pacew/kaleidoscope/mirror-template.tex

% GENERATED by cad/mirror_template.py -- edit that, not this.
\documentclass[letterpaper,10pt]{article}
\usepackage[letterpaper,landscape,top=10mm,bottom=8mm,left=12mm,right=12mm]{geometry}
\usepackage{tikz}
\usepackage{xcolor}
\pagestyle{empty}
\setlength{\parindent}{0pt}
\definecolor{reg}{gray}{0.45}
\definecolor{fac}{rgb}{0.70,0.15,0.10}
\newcommand{\cmark}[2]{%
  \draw[reg,line width=0.18mm] ({#1},{#2}) circle (1.4mm);
  \draw[reg,line width=0.18mm] ({#1-2.8},{#2}) -- ({#1+2.8},{#2});
  \draw[reg,line width=0.18mm] ({#1},{#2-2.8}) -- ({#1},{#2+2.8});
}
\begin{document}
\begin{center}
  {\large\bfseries Kaleidoscope mirror cutting template}\\[0.6mm]
  {\small 255 mm scope \quad\textperiodcentered\quad one blank per sheet
   \quad\textperiodcentered\quad drawn 1:1}
\end{center}
\vspace{0.5mm}
\fbox{\parbox{\dimexpr\linewidth-2\fboxsep-2\fboxrule\relax}{\small
\textbf{Print at 100\%.} \emph{Actual size}, not \emph{Fit to page}. Check the ruler
below with a real ruler first. This sheet is nearly as wide as the paper, so also check
that the circled marks at \emph{both} ends of the blank actually printed --- if either is
missing, your printer clipped the margins and everything here is short.}}
\vspace{2.5mm}

\begin{tikzpicture}[x=1mm,y=1mm]
  \draw[line width=0.35mm] (0,0) -- (101.6,0);
  \foreach \i in {0,10,...,100} {
    \draw[line width=0.25mm] (\i,0) -- (\i,-3.0);
    \node[below,font=\scriptsize,inner sep=1pt] at (\i,-3.0) {\i};
  }
  \foreach \i in {5,15,...,95} { \draw[line width=0.18mm] (\i,0) -- (\i,-1.8); }
  \node[left,font=\scriptsize,inner sep=1pt] at (-2.2,-3.2) {mm};
  \foreach \i/\lab in {0/0, 25.4/1, 50.8/2, 76.2/3, 101.6/4} {
    \draw[line width=0.25mm] (\i,0) -- (\i,3.0);
    \node[above,font=\scriptsize,inner sep=1pt] at (\i,3.0) {\lab};
  }
  \foreach \i in {12.7,38.1,63.5,88.9} { \draw[line width=0.18mm] (\i,0) -- (\i,1.8); }
  \node[left,font=\scriptsize,inner sep=1pt] at (-2.2,3.2) {in};
  \node[right,font=\small,align=left,inner sep=3pt] at (106,0)
        {0--100 below $=$ 100.0\,mm exactly\\0--4 above $=$ 4.000\,in exactly};
\end{tikzpicture}

\vspace{4mm}
\hspace*{-4.65mm}\begin{tikzpicture}[x=1mm,y=1mm,line width=0.30mm]
  \draw (1.2868,0.0000) -- (0.0000,25.8476) -- (254.1584,51.2161) -- (256.7081,0.0000) -- cycle;
  \cmark{1.2868}{0.0000}
  \cmark{0.0000}{25.8476}
  \cmark{254.1584}{51.2161}
  \cmark{256.7081}{0.0000}
  \draw[fac,line width=0.7mm] (-4.00,0) -- (260.71,0);
  \foreach \x in {-2,2,...,260} { \draw[fac!40,line width=0.15mm] (\x,0) -- ({\x-3},-3.2); }
  \node[fac,font=\scriptsize\bfseries,below right] at (-4.00,-4.6) {FACTORY EDGE OF THE TILE — lay this line on it. Never cut or sand along it.};
  \node[reg,font=\scriptsize,below right] at (-4.00,-9.4) {Everything below the line hangs off the tile, which is how you sight the alignment.};
  \node[font=\scriptsize,reg,rotate=5.70] at (127.08,41.93) {overlap edge — cut, buried behind the next mirror};
  \node[font=\scriptsize,fac] at (129.00,3.4) {leading edge — factory, uncut, coating right to the edge};
  \node[font=\scriptsize,reg,rotate=90] at (7.29,14) {narrow end};
  \node[font=\scriptsize,reg,rotate=90] at (249.71,26) {wide end};
\end{tikzpicture}
\vspace{3mm}
\hrule
\vspace{1.5mm}
{\footnotesize
\textbf{Blank:} parallel edges \textbf{25.88} and \textbf{51.28\,mm}, both slanted edges \textbf{255.42\,mm}, height between the parallel edges \textbf{255.11\,mm}. Needs 256.7\,mm of factory edge against a 298.45\,mm tile, so one blank per edge --- three edges, or three tiles.

\smallskip

\textbf{Placing it.} Leave the protective film on. Lay the sheet so the heavy line sits on
a factory edge, with the strip below it overhanging so you can sight the alignment, and tape
it down. Prick through the centre of the four circled marks, lift the paper, join the pricks
with your straightedge, and cut only the three non-factory edges.

\smallskip

\textbf{Coated side up.} These are rear-surface mirrors. A jeweller's saw cuts on the
downstroke, so the teeth enter the top face and break out of the bottom; coated side up puts
that breakout on the clear face. Blade: a \#2, teeth pointing toward the handle.

\smallskip

\textbf{Mark the factory edge} on the coated back as soon as the blank is free. Once the
other three edges are cut it is easy to lose track of which one it was, and at assembly it
has to end up on the corner-block side of its plate.

\smallskip

\textbf{Width is forgiving, and not in the way you would guess.} Each mirror is pushed until
its leading edge stops against its neighbour, so \emph{that} edge lands on the vertex whatever
the blank measures. Width only sets how much surplus buries itself behind the next mirror.
Anything from 25.1 to 27.0\,mm across the narrow edge will seat. Too wide is the direction that fights you --- past
the limit the surplus runs out of dead space and jams against the neighbouring plate. Too narrow
only costs you: with no surplus left, the next mirror's leading edge has nothing to land on and
the seam shows as a dark line. So if you are going to miss, miss narrow.

\smallskip

\textbf{Sanding.} Only the cut edges, never the factory edge: 400-grit silicon carbide to take
the burr off, 600 to finish.
}
\end{document}
