pacew/kaleidoscope/holder/top.png

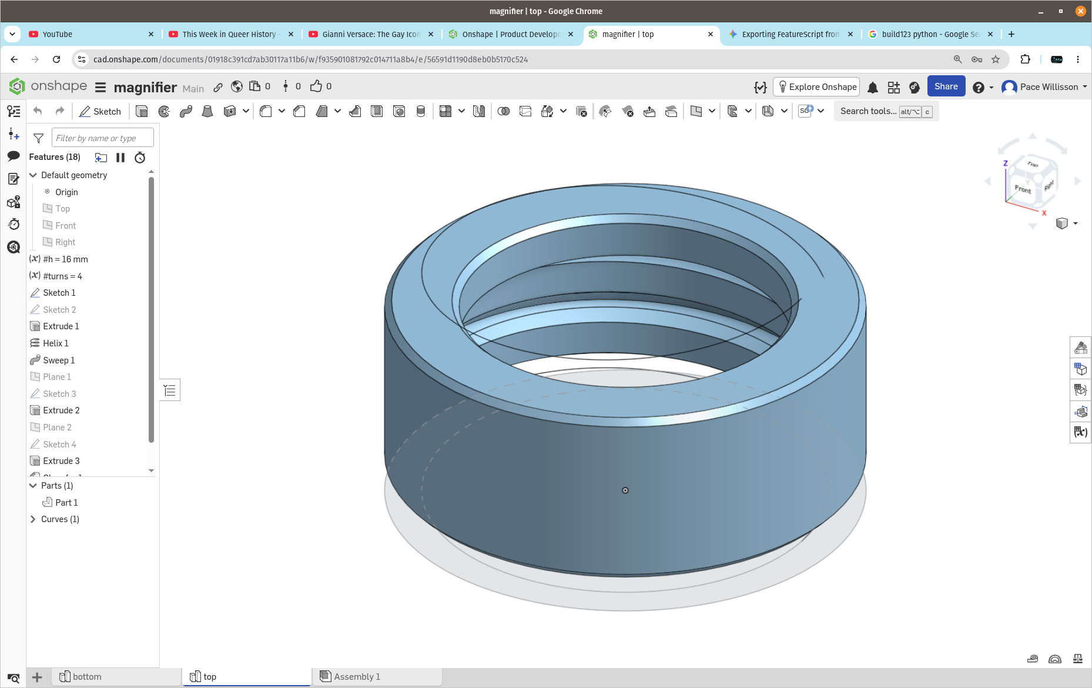
holder/top.png
