pacew/kaleidoscope/out/jewel_body.step

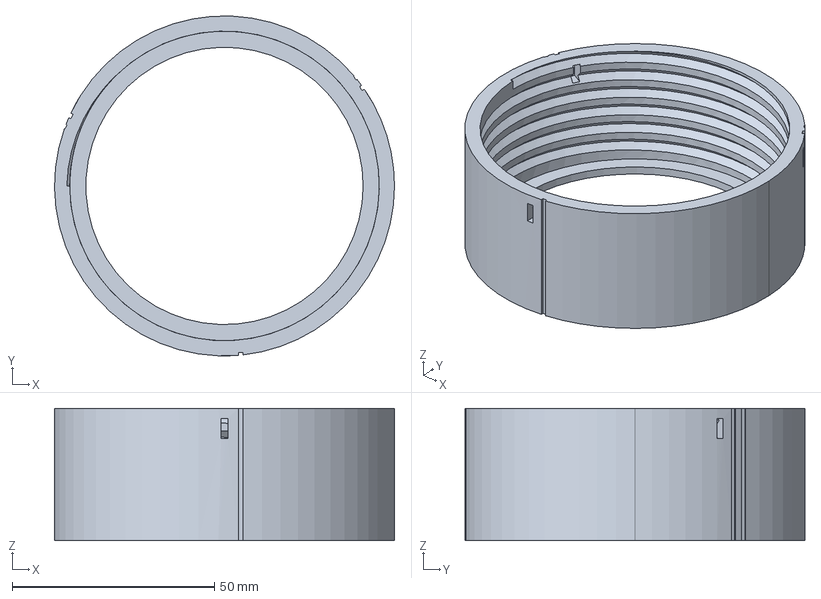
[picture p3: CAD file, 2026-09-15]
out/jewel_body.step
84.0 x 84.0 x 32.7 mm
