pacew/kaleidoscope/out/collar_225.step

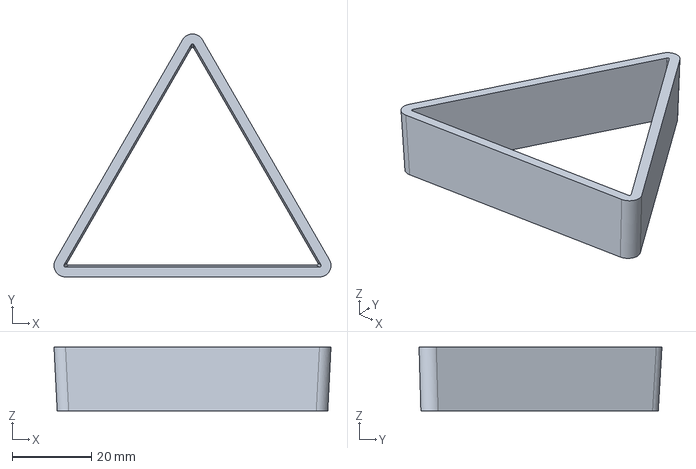
[picture p4: CAD file, 2026-09-15]
out/collar_225.step
69.7 x 61.1 x 16.0 mm
