pacew/kaleidoscope/out/jewel_test_spacer.step

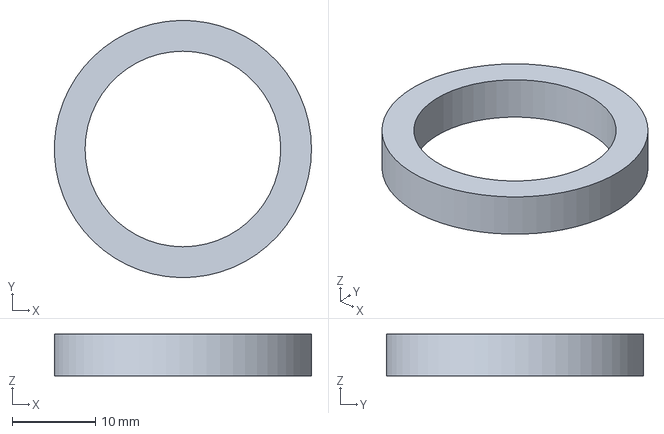
[picture p5: CAD file, 2026-09-15]
out/jewel_test_spacer.step
30.9 x 30.9 x 5.00 mm
