pacew/kaleidoscope/out/proto_side_plate.step

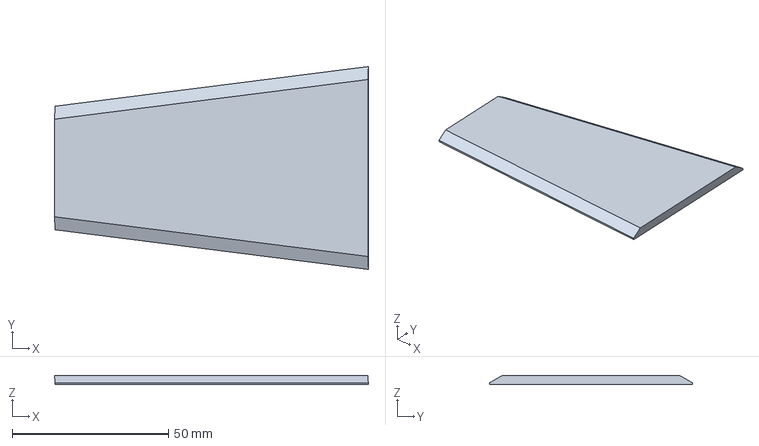
[picture p6: CAD file, 2026-09-15]
out/proto_side_plate.step
100.5 x 64.9 x 2.99 mm
