pacew/kaleidoscope/out/jewel_ring.step

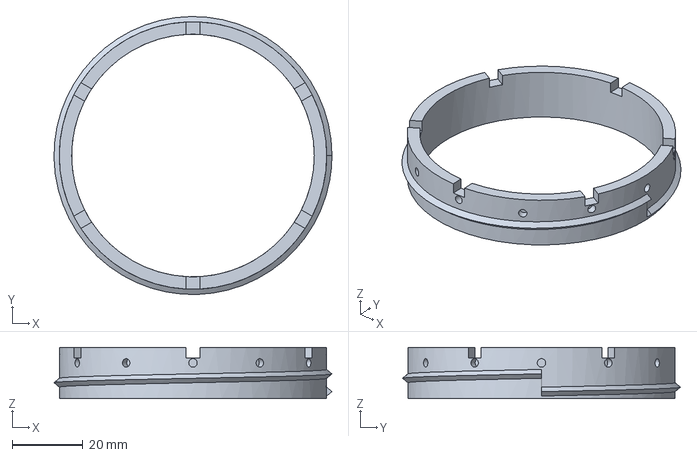
[picture p7: CAD file, 2026-09-15]
out/jewel_ring.step
78.5 x 78.5 x 14.5 mm
