pacew/kaleidoscope/out/collar_112.step

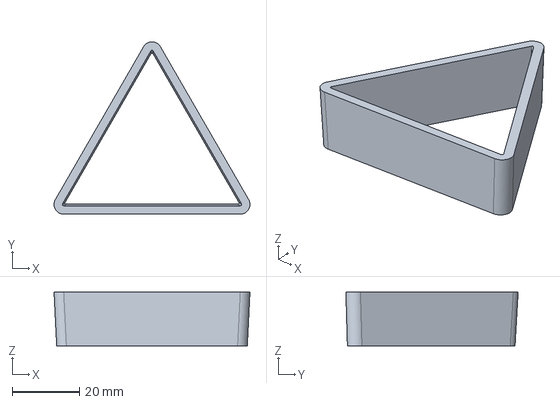
[picture p8: CAD file, 2026-09-15]
out/collar_112.step
58.5 x 51.4 x 16.0 mm
