pacew/kaleidoscope/out/small_cap.step

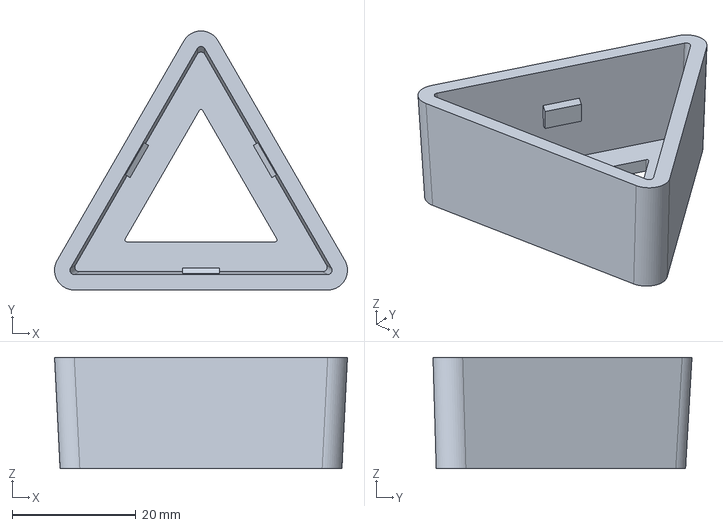
[picture p9: CAD file, 2026-09-15]
out/small_cap.step
47.4 x 41.9 x 18.0 mm
