pacew/kaleidoscope/out/jewel_test_body.step

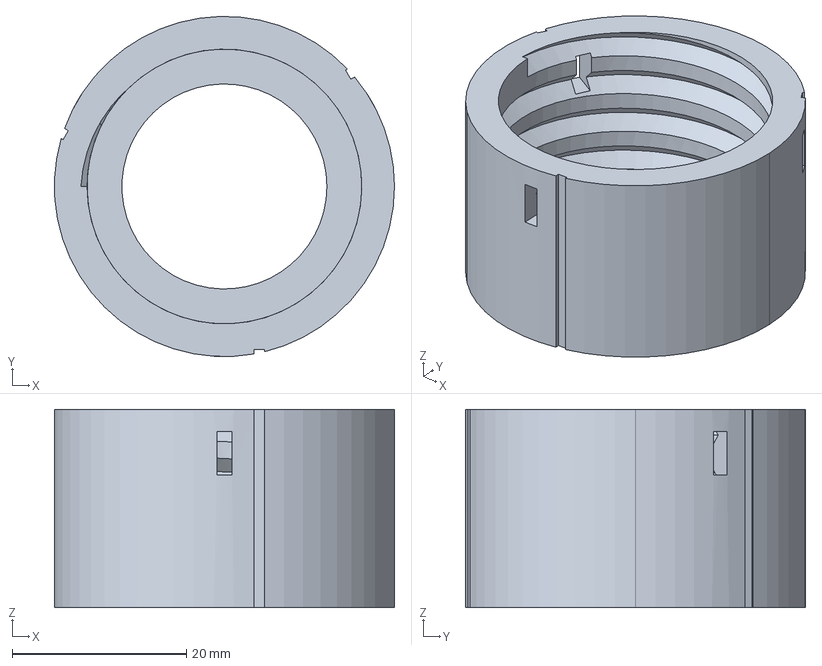
[picture p10: CAD file, 2026-09-15]
out/jewel_test_body.step
39.0 x 39.0 x 22.7 mm
