pacew/kaleidoscope/out/side_plate.step

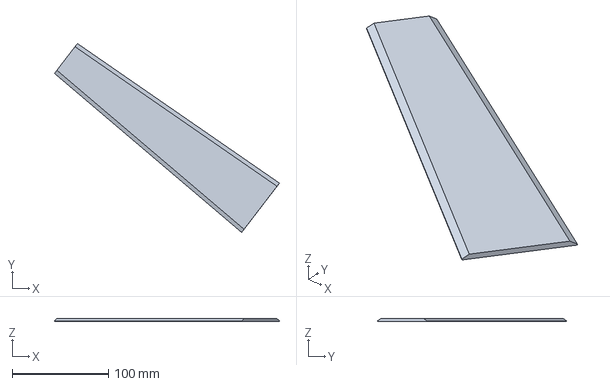
[picture p11: CAD file, 2026-09-15]
out/side_plate.step
234.0 x 196.5 x 3.00 mm
