pacew/kaleidoscope/out/proto_collar_74.step

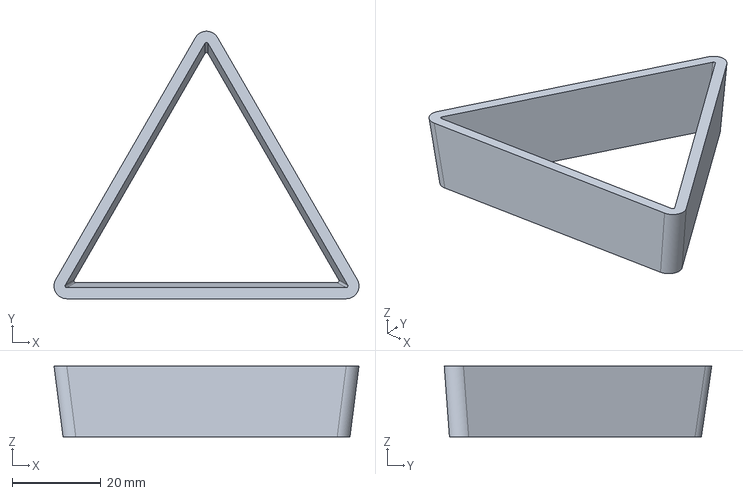
[picture p12: CAD file, 2026-09-15]
out/proto_collar_74.step
68.9 x 60.4 x 16.0 mm
