pacew/kaleidoscope/out/jewel_spacer.step

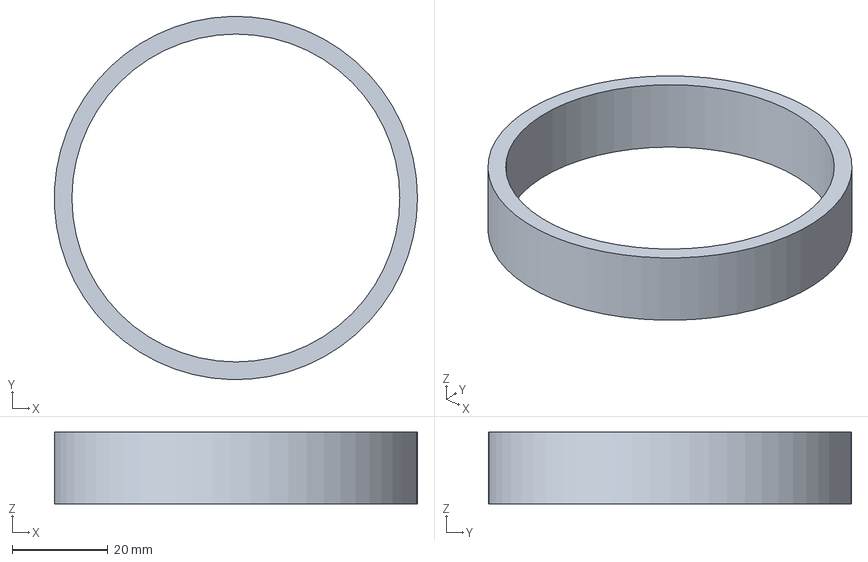
[picture p13: CAD file, 2026-09-15]
out/jewel_spacer.step
75.8 x 75.9 x 15.0 mm
