pacew/kaleidoscope/out/proto_large_cap.step

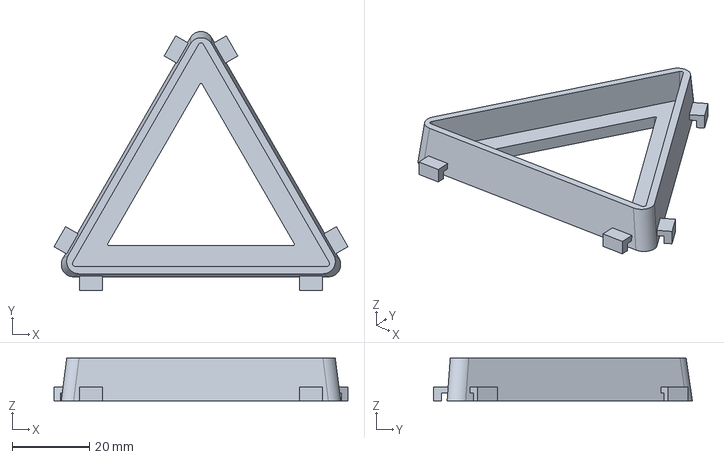
[picture p14: CAD file, 2026-09-15]
out/proto_large_cap.step
76.0 x 66.9 x 11.0 mm
