pacew/kaleidoscope/out/proto_small_cap.step

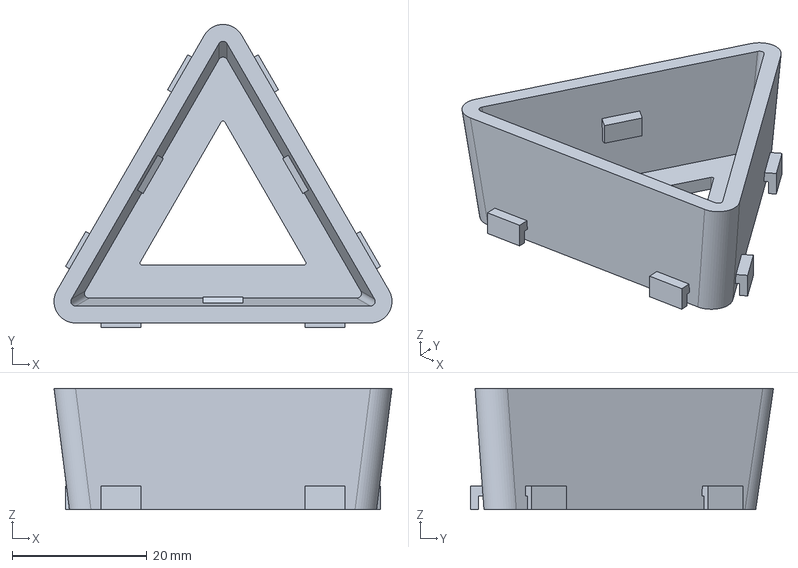
[picture p15: CAD file, 2026-09-15]
out/proto_small_cap.step
50.2 x 45.0 x 18.0 mm
