pacew/kaleidoscope/out/jewel_test_ring.step

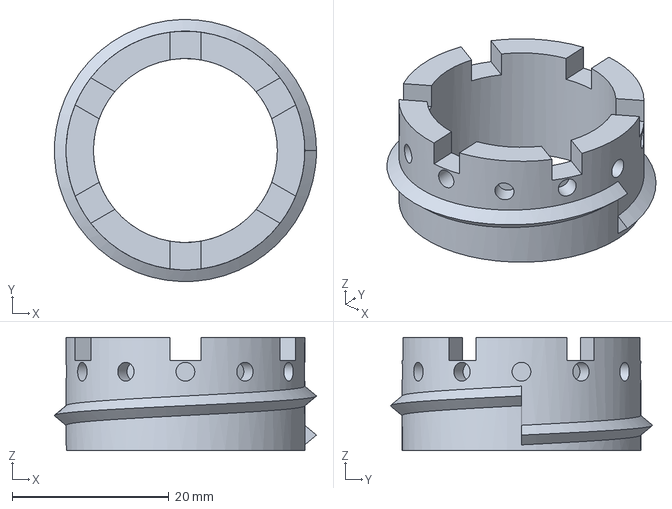
[picture p16: CAD file, 2026-09-15]
out/jewel_test_ring.step
33.5 x 33.5 x 14.5 mm
