pacew/kaleidoscope/out/collar_55.step

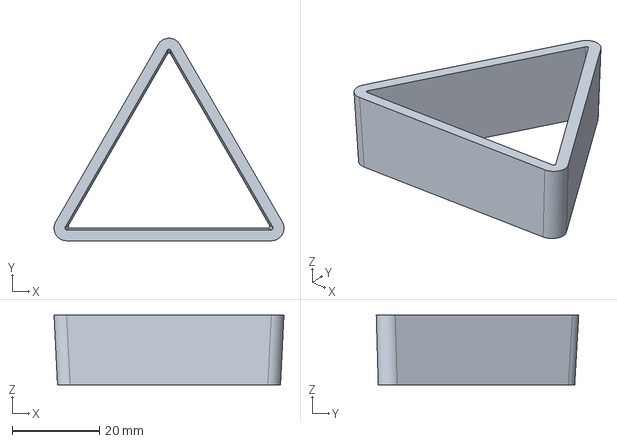
[picture p17: CAD file, 2026-08-17]
out/collar_55.step
52.8 x 46.5 x 16.0 mm
