pacew/kaleidoscope/out/bed_test.step

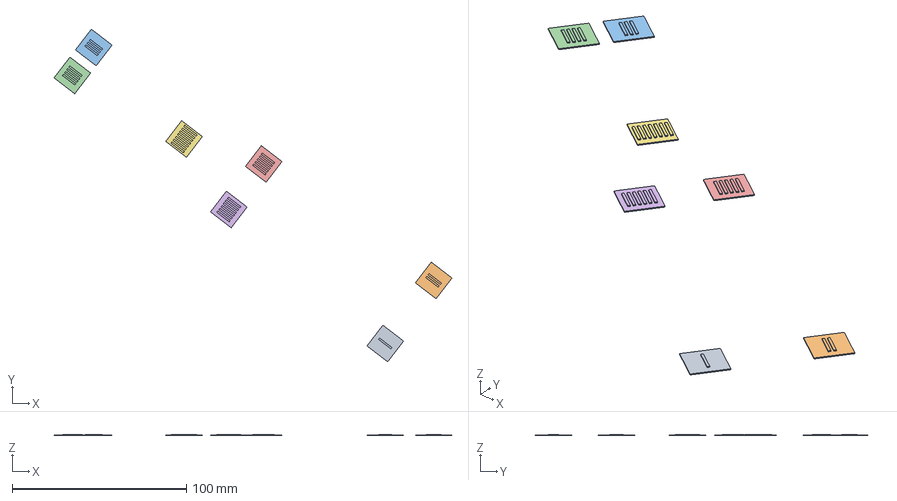
[picture p18: CAD file, 2026-08-17]
out/bed_test.step
228.4 x 190.9 x 0.8 mm
