pacew/kaleidoscope/out/collar_140.step

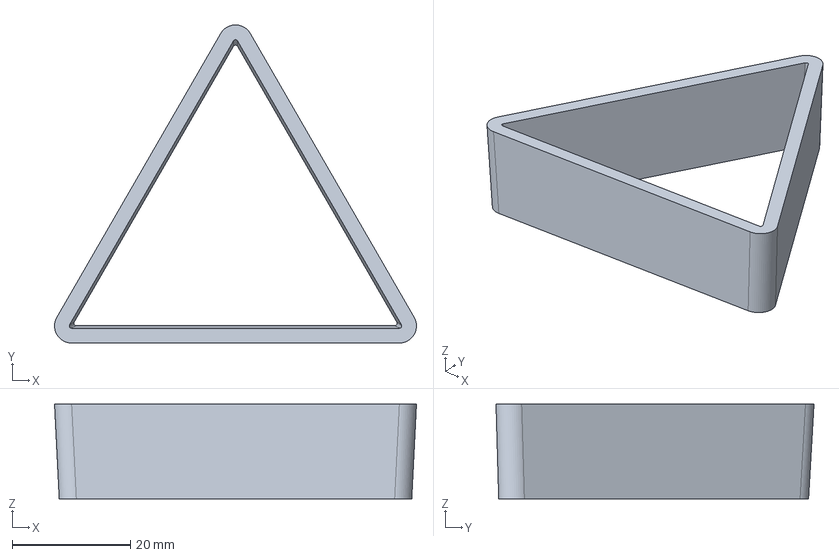
[picture p19: CAD file, 2026-08-17]
out/collar_140.step
61.2 x 53.8 x 16.0 mm
