pacew/kaleidoscope/(list of files, cad)

Other CAD files:
out/bed_test.stl
out/collar_112.stl
out/collar_140.stl
out/collar_225.stl
out/collar_55.stl
out/jewel_body.stl
out/jewel_ring.stl
out/jewel_spacer.stl
out/jewel_test_body.stl
out/jewel_test_ring.stl
out/jewel_test_spacer.stl
out/proto_collar_74.stl
out/proto_large_cap.stl
out/proto_side_plate.stl
out/proto_small_cap.stl
out/side_plate.stl
out/small_cap.stl
