pacew/kaleidoscope/(commit log)

2026-08-17 working on large scope
    [bed_test.step, bed_test.stl, collar_140.step, collar_140.stl, collar_225.step, collar_225.stl, collar_55.step, collar_55.stl]
2026-08-19 Open the aperture, take up the detent play, record the real mirror thickness
    Small cap: split the one shared corner radius into bore_corner (0.7, sets the
    fit over the plates' points) and ap_corner (0.3, purely optical), and make the
    aperture lip explicit at 0.294 mm rather than "half a mirror". Corner bite
    2.29 -> 0.89 mm. The lip is cosmetic either way -- the mirror's end face bears
    on the cap floor over its full thickness regardless.
    Side plate: the detent pocket is lopsided now instead of centred. The plate
    bottoms on the cap floor, so the only motion left is back out, which loads the
    pocket's low wall alone; that wall gets 0.35 mm and sets the play, the high
    wall keeps 1.0 for an easy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
    [collar_112.step, collar_112.stl, collar_225.step, side_plate.step, side_plate.stl, small_cap.step, small_cap.stl]
2026-09-15 work from 2026-08-22
    [collar_112.step, collar_225.step, jewel_body.step, jewel_body.stl, jewel_ring.step, jewel_ring.stl, jewel_spacer.step, jewel_spacer.stl]
